davidc/weekett-replacement/Replacement comms board rev 1.1/BOM_JLCSMT r1.1.xlsx

Comment | Designator | Footprint | JLCPCB Part #（optional）
1uF | C1 | 0805 | C28323
100nF | C2 | 0805 | C28233
BSS138 | Q1,Q2 | SOT-23 | C7420339
10k | R1,R2,R3,R4 | 0805 | C17414
