davidc/weekett-replacement/WeeKett original power board/WeeKett original power board schematic.pdf

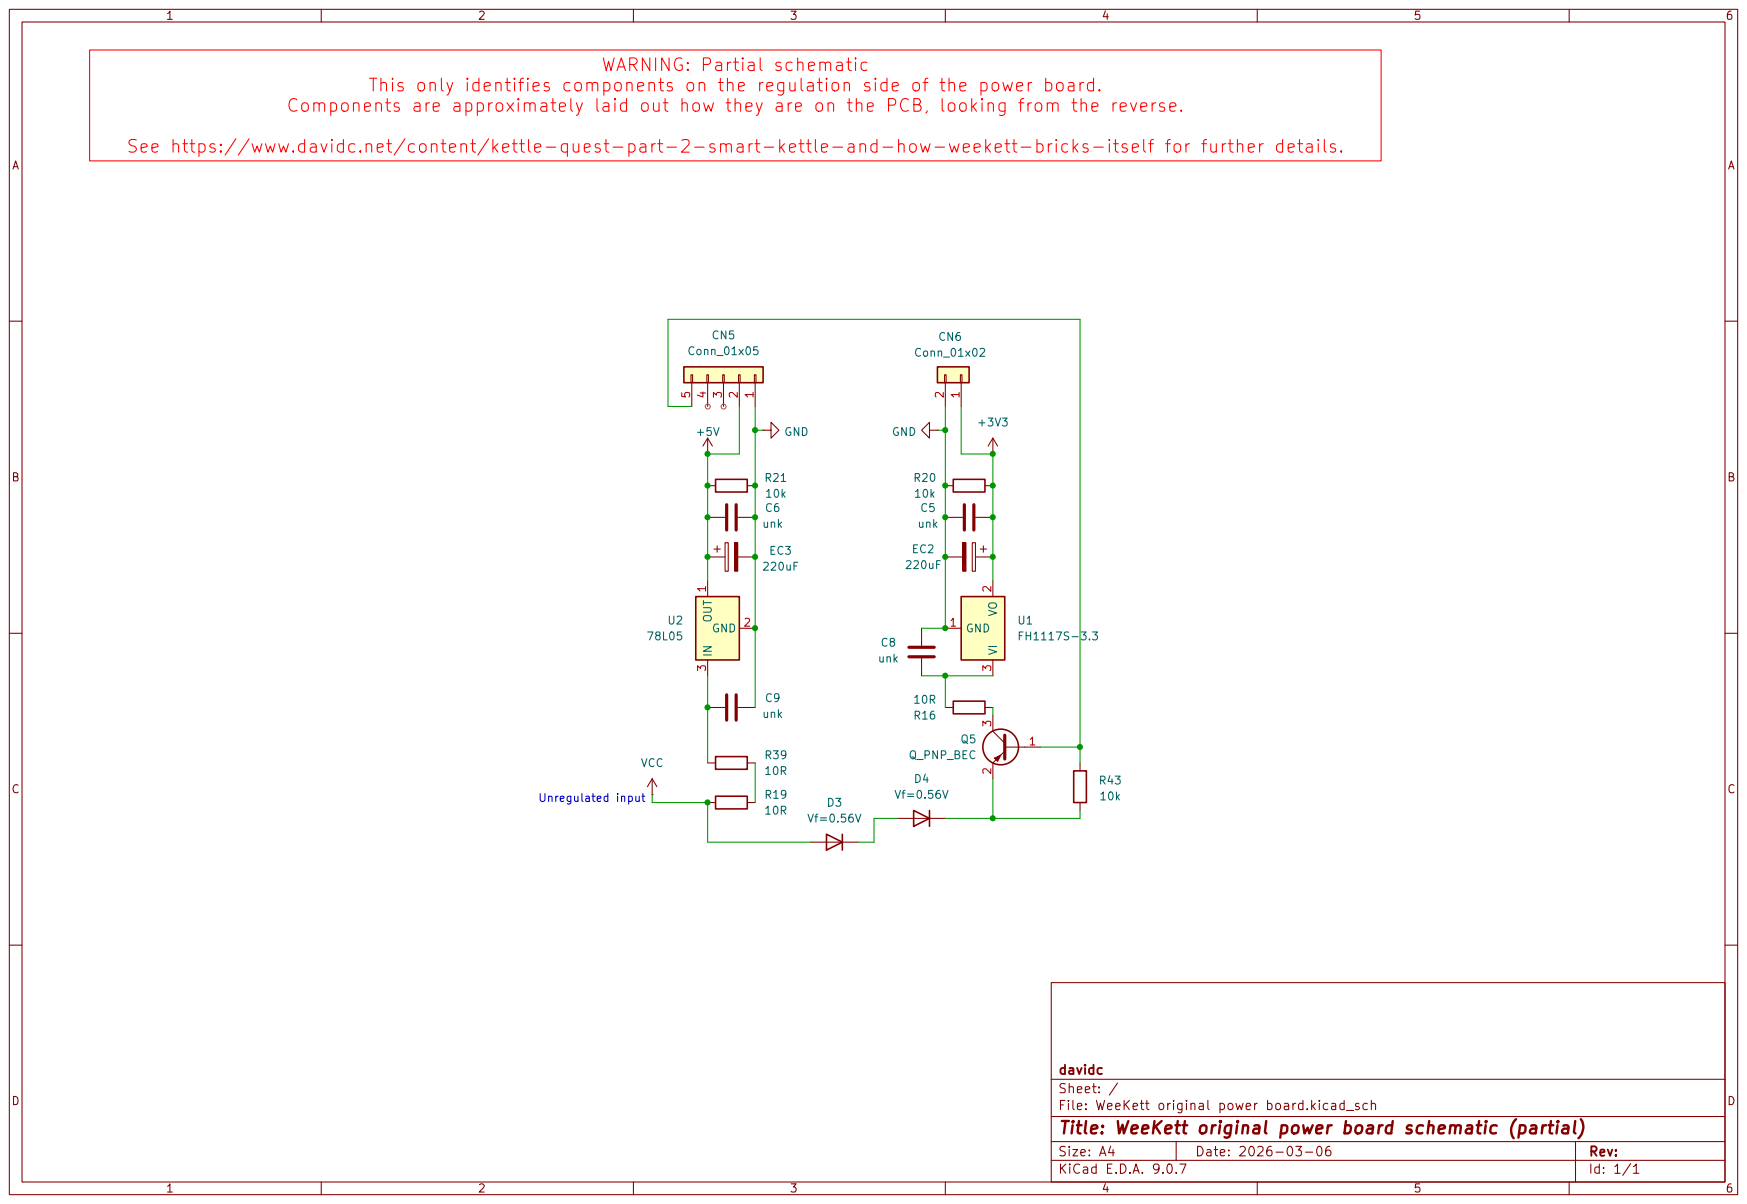
[picture p1: page 1]
