davidc/weekett-replacement/Replacement comms board rev 0.1/WeeKett comms board.kicad_pcb

## KiCad design Replacement comms board rev 0.1/WeeKett comms board.kicad_pcb (2026-03-06, an earlier design)

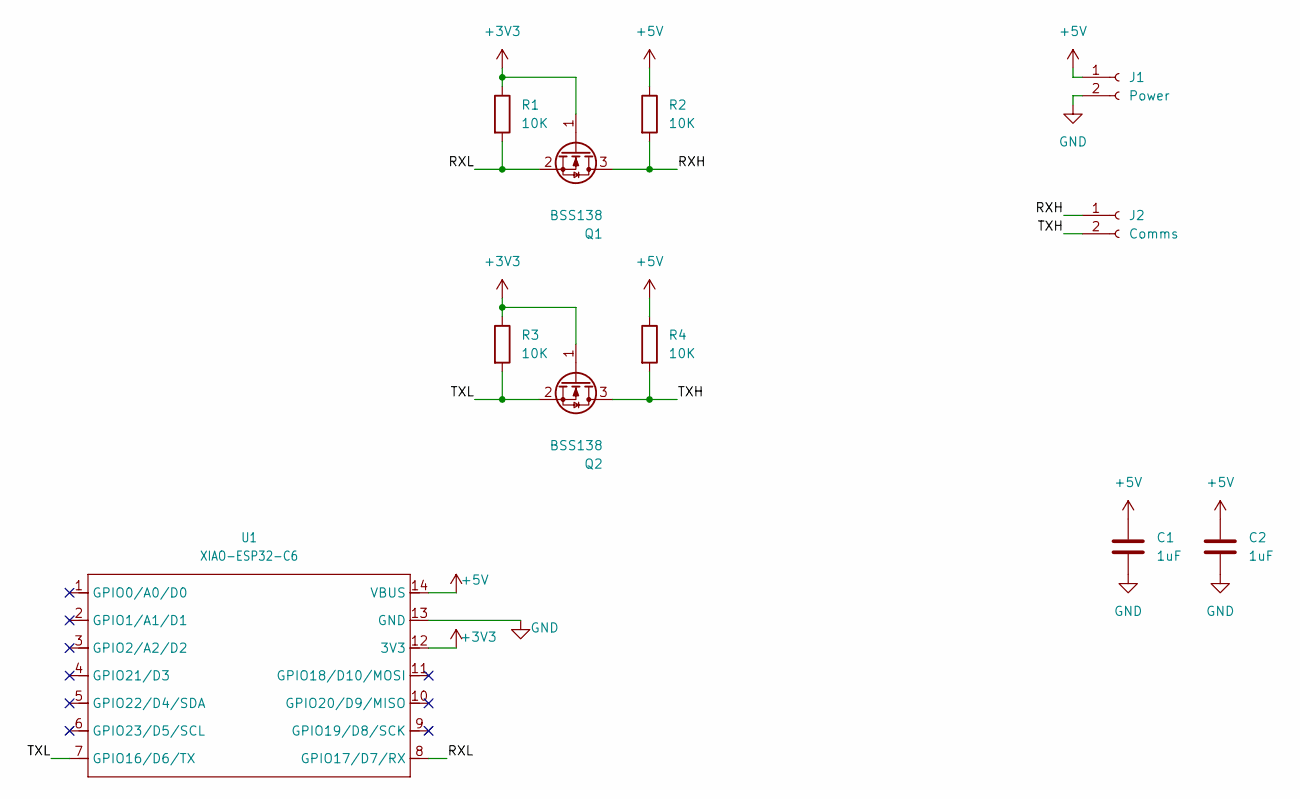
[picture p5: schematic WeeKett comms board.kicad_sch]

Parts:
C1, C2: 1uF; C_0603_1608Metric
J1: Power; PinHeader_1x02_P2.54mm_Vertical
J2: Comms; PinHeader_1x02_P2.54mm_Vertical
Q1, Q2: BSS138; SOT-23
R1, R2, R3, R4: 10K; R_0603_1608Metric
U1: XIAO-ESP32-C6; XIAO-ESP32C6-DIP

Connections:
+3V3: Q1.1 (G), Q2.1 (G), R1.1, R3.1, U1.12 (3V3)
+5V: C1.1, C2.1, J1.1, R2.1, R4.1, U1.14 (VBUS)
/RXH: J2.1, Q1.3 (D), R2.2
/RXL: Q1.2 (S), R1.2, U1.8 (GPIO17/D7/RX)
/TXH: J2.2, Q2.3 (D), R4.2
/TXL: Q2.2 (S), R3.2, U1.7 (GPIO16/D6/TX)
GND: C1.2, C2.2, J1.2, U1.13 (GND)

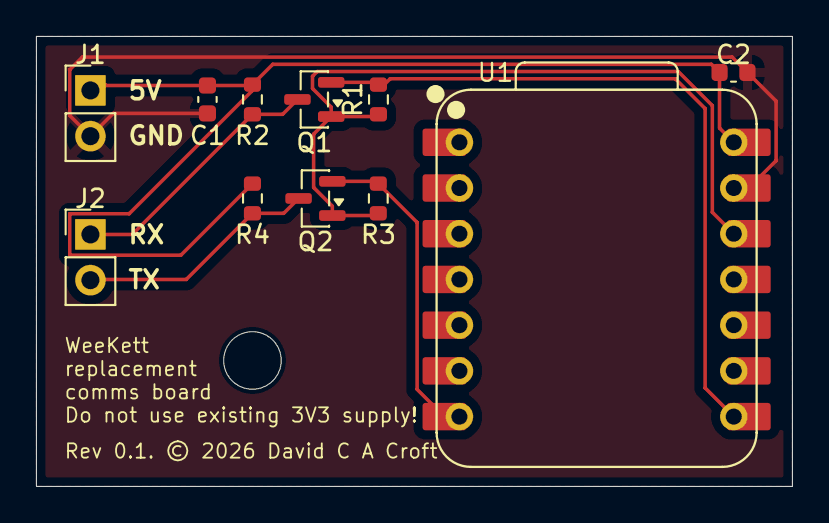
[picture p6: board Replacement comms board rev 0.1/WeeKett comms board.kicad_pcb from above]

Board: 2 copper layers, 42.0 x 25.0 mm, 11 parts (0 on the bottom side), 7 nets.
