davidc/weekett-replacement/esphome/weekett-replacement.yaml

packages:
  - !include includes/debug.yaml

esphome:
  name: weekett-replacement
  friendly_name: "WeeKett Replacement"

esp32:
  board: seeed_xiao_esp32c3
  framework:
    type: esp-idf

# Logging
logger:

# Home Assistant API
api:
  encryption:
    key: !secret weekett_replacement_api_key

# OTA upgrades
ota:
  - platform: esphome
    password: !secret weekett_replacement_ota_password

# WiFi
wifi:
  ssid: !secret wifi_ssid
  password: !secret wifi_password
  use_address: 192.168.40.23

  # Fallback hotspot (captive portal)
  ap:
    ssid: "Weekett-Replacement"
    password: "12345678"

captive_portal:

# Enable UART
uart:
  tx_pin: GPIO21
  rx_pin: GPIO20
  baud_rate: 9600
  # debug:

# Enable Tuya MCU protocol via UART
tuya:
  # These two datapoints need to publish here, otherwise ESPhome will convert them to a float by the time they reach the entity's on_raw_value
  on_datapoint_update:
    - sensor_datapoint: 19 # problem bitfield 
      datapoint_type: bitmask
      then:
        - binary_sensor.template.publish:
            id: kettle_absent
            state: !lambda 'return (x & 0x02);'
    - sensor_datapoint: 15 # status
      datapoint_type: enum
      then:
        - text_sensor.template.publish:
            id: status
            state: !lambda |-
              switch (x) { // I've only witnessed states 0, 1 and 3
                case 0:
                  return "standby";
                case 1:
                  return "heating";
                case 2:
                  return "cooling"; // possibly intended for HVAC?
                case 3:
                  return "keeping_warm";
                case 4:
                  return "heating_temp"; // tuya local thinks this is "no_water", but I can't trigger this with an empty kettle, it just boils dry
                case 5:
                  return "boiling_temp"; // unknown purpose
                default:
                  return "unknown";
              }

sensor:
  - id: current_temperature
    name: "Current Temperature"
    platform: tuya
    sensor_datapoint: 2
    device_class: temperature
    unit_of_measurement: °C
    filters:
      - lambda: |-
          if (id(kettle_absent).state) return {};
          return x;
    # on_value:
    #   then:
    #     - water_heater.template.publish:
    #         id: kettle
    #         current_temperature: !lambda 'return x;'

  - id: problem_bitfield
    name: "Problem Bitfield"
    platform: tuya
    sensor_datapoint: 19
    entity_category: diagnostic
    disabled_by_default: true

  - id: status_raw
    name: "Status Raw"
    platform: tuya
    sensor_datapoint: 15
    entity_category: diagnostic
    disabled_by_default: true

binary_sensor:
  - id: kettle_absent
    name: "Kettle Absent"
    platform: template

text_sensor:
  - id: status
    name: "Status"
    platform: template

number:
  - id: setpoint_temperature
    name: "Setpoint Temperature"
    platform: tuya
    number_datapoint: 8
    min_value: 40
    max_value: 100
    step: 1
    device_class: temperature
    unit_of_measurement: °C
    # on_value:
    #   then:
    #     - water_heater.template.publish:
    #         id: kettle
    #         target_temperature: !lambda ' ESP_LOGI("setpoint", "New setpoint: %d", x); return x;'   

switch:
  - id: operation_mode
    name: "Operation Mode"
    platform: tuya
    switch_datapoint: 1
    # on_state:
    #   then:
    #     - water_heater.template.publish:
    #         id: kettle
    #         is_on: !lambda 'return x;'
    #         mode: !lambda 'return x ? water_heater::WATER_HEATER_MODE_ELECTRIC : water_heater::WATER_HEATER_MODE_OFF;'

  - platform: tuya
    name: "Keep Warm"
    switch_datapoint: 13
  - platform: tuya
    name: "Bottle Warming"
    switch_datapoint: 101

water_heater:
  - id: kettle
    name: None # "Kettle"
    platform: template
    optimistic: true
    current_temperature: !lambda 'return id(current_temperature).state;'
    target_temperature: !lambda 'return id(setpoint_temperature).state;'
    is_on: !lambda 'return id(operation_mode).state;'
    mode: !lambda 'return id(operation_mode).state ? water_heater::WATER_HEATER_MODE_ELECTRIC : water_heater::WATER_HEATER_MODE_OFF;'
    icon: mdi:kettle
    visual:
      min_temperature: 40
      max_temperature: 100
      target_temperature_step: 5
    supported_modes:
      - "OFF"
      - ELECTRIC
    set_action:
      - lambda: |-
          ESP_LOGI("boiler", "New mode: %d", id(kettle).get_mode());
          ESP_LOGI("boiler", "New target temperature: %.1f", id(kettle).get_target_temperature());
          ESP_LOGI("boiler", "On: %s, Away: %s", YESNO(id(kettle).is_on()), YESNO(id(kettle).is_away()));
          auto call = id(setpoint_temperature).make_call();
          call.set_value(id(kettle).get_target_temperature());
          call.perform();
          id(operation_mode).control(id(kettle).is_on());


# [00:29:32.474][C][tuya:052]: Tuya:
# [00:29:32.474][C][tuya:069]:   Datapoint 1: switch (value: OFF) - operation mode ✅
# [00:29:32.475][C][tuya:071]:   Datapoint 2: int value (value: 0) - current C ✅
# [00:29:32.475][C][tuya:071]:   Datapoint 3: int value (value: 0) - [current F]
# [00:29:32.475][C][tuya:071]:   Datapoint 8: int value (value: 80) - setpoint C ✅
# [00:29:32.483][C][tuya:071]:   Datapoint 9: int value (value: 176) - [setpoint F]
# [00:29:32.483][C][tuya:075]:   Datapoint 12: enum (value: 0) - temperature unit [TODO force to C on startup, just in case]
# [00:29:32.483][C][tuya:069]:   Datapoint 13: switch (value: OFF) - keep warm ✅
# [00:29:32.487][C][tuya:075]:   Datapoint 15: enum (value: 0) - status ✅
# [00:29:32.495][C][tuya:077]:   Datapoint 19: bitmask (value: 2) - problems ✅
# [00:29:32.496][C][tuya:069]:   Datapoint 101: switch (value: OFF) - bottle warming ✅
# [00:29:32.497][C][tuya:087]:   Product: '{"p":"01rtpfyd3amxdsps","v":"1.0.0","m":0}'

# TODO I've made it not publish current temperature if the kettle is off-hook, but is it possible to publish an actual "unknown"?
# TODO test minimum set point, it appears it might be unable to heat to less than 56C?
# TODO is there a problem bitfield flag for "no water"? it doesn't seem to detect this
# TODO what is problem bitfield flag 1, is it "at temperature"? It showed up when it reached boil
