davidc/weekett-replacement/(commit log)

2026-03-06 Initial schematic and PCB import
    [BOM_JLCSMT r1.1.xlsx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]
2026-03-08 initial attempts to use an esphome water_heater don't publish current temperature if kettle is off-hook
