davidc/weekett-replacement/(notices)

Notices in the files:
Replacement comms board rev 0.1/WeeKett comms board.kicad_pcb:
Rev 0.1. © 2026 David C A Croft
Replacement comms board rev 1.1/WeeKett comms board.kicad_pcb:
Rev 1.1 2026-02-17 © davidc
Replacement comms board rev 1.0/WeeKett comms board.kicad_pcb:
Rev 1.0 2026-01-21 © 2026
